SunYifan-IrV/Aircraft_Structure_design/README.md

# 飞行器结构设计 —— "人机合一"低空个人飞行器

> 第十二小组 · 飞行器结构设计大作业
> 一型低空个人飞行器（固定翼滑翔型）的**结构设计**全流程交付：需求 → 理论 → CATIA 建模 → 仿真校核 → 报告 / 汇报。

## 一句话定位

一根 13 m 碳纤维刚性梯形机翼 + 中央承力盒/龙骨 + 乘员俯卧挂载 + 后置折叠电推进 + 重心移动操纵 + 双腿起降的**无尾飞翼式单人动力滑翔机**。乘员不是乘客，而是结构—传力—操纵链中的一环（"人机合一"）。

## 目录结构

| 目录 | 内容 | 关键交付物 |
|---|---|---|
| [`00_Requirments`](00_Requirments/) | 设计需求冻结 | 设计需求、质量预算、载荷工况 |
| [`01_Theory`](01_Theory/) | 理论设计 | 总体参数、翼型/速度、升力分布/翼根内力、翼面结构、中央承力框架 |
| [`02_CATIA`](02_CATIA/) | 三维建模 | 设计思路、逐部件尺寸规格、CATPart |
| [`03_FEA`](03_FEA/) | 仿真分析 | 网格/应力/气动报告、数值结果、图件 |
| [`04_Report`](04_Report/) | 分析报告 | 汇总报告（docx） |
| [`05_Presentation`](05_Presentation/) | 答辩汇报 | 汇报 PPT |
| [`06_AI_Statment`](06_AI_Statment/) | AI 使用说明 | AI 使用声明 |

## 设计一页摘要

| 项 | 值 |
|---|---|
| 起飞质量 | 名义 135 kg / MTOW 155 kg（空机 60 kg） |
| 机翼 | S = 20 m²，b = 13 m，AR = 8.45，λ = 0.5，MAC = 1.60 m |
| 翼型 | 主翼 Wortmann FX 63-137，翼尖 E387 过渡 + −2° 洗流 |
| 速度 | V_stall 8.5–9.1 m/s，V_C = 15 m/s，V_NE = 25 m/s，V_D = 27.8 m/s |
| 翼根内力（极限 +6g） | V = 4.6 kN，M = 12.9 kN·m |
| 主梁 | CFRP 盒型梁，d = 200 mm，缘条 20×8 mm（根），夹芯腹板 |
| 翼肋 / 蒙皮 | 泡沫夹芯翼肋 @0.45 m（14 肋/侧）；±45° CFRP + Nomex D-box |
| 翼根连接 | 中央承力盒 + 7075-T6 铰耳/销（折叠） |
| 人体支撑 | 躯干成型托板，接触压力 ≤ 15 kPa @+4g |
| 支配约束 | 阵风（缓和后 n≈3g < +6g 机动）、颤振（D-box 抗扭） |

## 关键结论

1. 低失速（8–9 m/s 双脚软着陆）强制出**大翼面积 20 m²、低翼载 ~66–76 N/m²、高展弦比 8.45**；
2. 主梁按 **+4g/+6g 机动极限**设计（翼根 M = 12.9 kN·m），阵风经缓和因子后（n≈3g）不超机动极限，但运行包线须限制强阵风高速飞行；
3. **人体必须用大面积躯干托板（非窄带）**传递载荷，+4g 接触压力 14.9 kPa 才能满足生物力学限值；
4. **中央承力盒**是气动载荷、人体反力、螺旋桨推力、起降冲击四类载荷的汇合枢纽。

## 快速导航

- 设计需求：`00_Requirments/00_设计需求.md`
- 理论总览：`01_Theory/00_理论设计总览.md`
- 建模思路：`02_CATIA/00_设计思路.md`；逐部件尺寸：`02_CATIA/02_详细设计描述.md`
- 仿真交付：`03_FEA/README_交付说明.md`
- 汇总报告：`04_Report/分析报告.docx`
- 答辩汇报：`05_Presentation/飞行器结构设计报告.pptx`
- AI 使用声明：`06_AI_Statment/AI使用声明.md`

## 工具与可复现性

- **理论计算**：AI 辅助编写的 Python 脚本 `calc_wing.py` —— 全部数值可复现，改动参数后重跑即更新；
- **仿真**：Python 3.12 + numpy + python-docx + Pillow + gmsh 4.15.2，网格划分、升力线气动与梁模型强度计算均由脚本完成；
- **建模**：CATIA V5R21（`02_CATIA/PersonalAircraft_Structural_RevP.CATPart`）；
- **文档 / 汇报**：Word / PowerPoint（报告、汇报 PPT）。
