SunYifan-IrV/Aircraft_Structure_design/01_Theory/00_理论设计总览.md

# 00 理论设计总览（01_Theory）

本目录完成“人机合一”低空个人飞行器（固定翼滑翔型）的**理论设计**：总体参数、气动（翼型/速度/升力分布/翼根内力）与结构初步选型。

## 文档索引

| 文件 | 内容 | 对应任务 |
|---|---|---|
| [01_总体质量与翼面参数.md](01_总体质量与翼面参数.md) | 总质量、翼面积、翼展/弦长/展弦比 | 任务 1、2 |
| [02_翼型选择与设计速度.md](02_翼型选择与设计速度.md) | 候选翼型、设计飞行速度 | 任务 3 |
| [03_升力分布与翼根内力.md](03_升力分布与翼根内力.md) | Schrenk 升力分布、翼根剪力/弯矩、阵风 | 任务 4 |
| [04_翼面结构初步设计.md](04_翼面结构初步设计.md) | 翼梁/翼肋/蒙皮/翼根连接 | 任务 5 |
| [05_中央承力框架与人体传力路径.md](05_中央承力框架与人体传力路径.md) | 中央承力框架、人体支撑载荷链 | 任务 6 |
| `calc_wing.py`（本地保留） | 全部数值的可复现计算脚本，AI 辅助编写，未随仓库公开 | 校核/溯源 |

## 设计点一页摘要

| 项 | 值 |
|---|---|
| 起飞质量 | 名义 135 kg / MTOW 155 kg（空机 60 kg） |
| 机翼 | S = 20 m²，b = 13 m，AR = 8.45，λ = 0.5，MAC = 1.60 m |
| 翼型 | 主翼 Wortmann FX 63-137，翼尖 E387 过渡 + −2° 洗流 |
| 速度 | V_stall 8.5–9.1 m/s，V_C = 15 m/s，V_NE = 25 m/s，V_D = 27.8 m/s |
| 翼根内力（极限 +6g） | V = 4.6 kN，M = 12.9 kN·m |
| 主梁 | CFRP 盒型梁，d=200 mm，缘条 20×8 mm（根），夹芯腹板 |
| 翼肋/蒙皮 | 泡沫夹芯翼肋 @0.45 m（14 肋/侧）；±45° CFRP + Nomex D-box |
| 翼根连接 | 中央承力盒 + 7075-T6 铰耳/销（折叠） |
| 人体支撑 | 躯干成型托板，接触压力 ≤ 15 kPa @+4g |
| 支配约束 | 阵风（缓和后 n≈3g < +6g 机动）、颤振（D-box 抗扭） |

## 关键结论

1. 低失速（8–9 m/s 软着陆）强制出**大翼面积 20 m²、低翼载 ~66–76 N/m²**、高展弦比 8.45；
2. 主梁按 **+4g/+6g 机动极限**设计（翼根 M=12.9 kN·m），阵风经缓和因子后（n≈3g）不超机动极限，但运行包线须限制强阵风高速飞行；
3. **人体必须用大面积躯干托板**（非窄带）传递载荷，+4g 接触压力 14.9 kPa 才能满足生物力学限值；
4. 中央承力盒是气动载荷、人体反力、螺旋桨推力、起降冲击四类载荷的汇合枢纽。

## 后续衔接

- `02_CATIA`：翼型曲线、平面形状、中央承力盒/龙骨/托板的几何建模；
- `03_FEA`：主梁/翼根接头/承力盒强度与屈曲、颤振/气弹校核、接触压力细化；
- 本目录所有数值由计算脚本 `calc_wing.py` 生成（AI 辅助编写，小组本地保留，未随仓库公开），改动参数后重新运行即可更新。
