SunYifan-IrV/Aircraft_Structure_design/02_CATIA/02_详细设计描述.md

# 02 详细设计描述 —— 逐部件几何与结构规格

> 本文件是 **CATIA 建模的完整尺寸规格**。
> 设计思路见 [`00_设计思路.md`](00_设计思路.md)；数值源头为 `01_Theory` 的计算脚本 `calc_wing.py`（小组本地保留，未随仓库公开）。

## 0. 坐标系与基准

- **机体坐标系**：原点 = 根弦前缘 @ 机身中线 @ 弦线高度；
  - `x` 向后（顺气流，+x = 尾向），`y` 向右翼（+y = 右/星侧），`z` 向上；
- **基准平面**：弦线平面 z=0（机翼参考弦线所在平面），纵平面 y=0，翼根平面 x 为机翼展向坐标。
- 图纸比例 1:12.5；单位统一为 **m / kg / N**。

---

## 1. 总体参数（设计点冻结）

| 参数 | 符号 | 数值 |
|---|---|---|
| 名义 / 最大起飞质量 | m | 135 / 155 kg |
| 空机质量 | m₀ | 60 kg |
| 机翼面积 | S | 20 m² |
| 翼展 | b | 13 m（半翼展 6.5 m，折叠后 ~5.7 m/段） |
| 展弦比 | AR | 8.45 |
| 锥度比 | λ | 0.5 |
| 根弦 / 梢弦 | c_r / c_t | 2.05 / 1.03 m |
| 平均几何弦长 / 平均气动弦长 | c̄ / MAC | 1.54 / 1.60 m（MAC 位于 y=2.89 m） |
| 翼载（名义/最大） | W/S | 66.2 / 76.1 N/m² |
| 设计最大升力系数 | CLmax | 1.5 |
| 失速 / 巡航 / 极限速度 | V | 8.5–9.1 / 13.4–15.5 / 25 m/s |
| 翼根极限内力（+6g） | V_ult / M_ult | 4.56 kN / 12.88 kN·m（单侧） |
| 总长 / 总高（折叠态参照） | — | ≈ 2.2 m（桨至头）/ ≈ 1.5 m（翼面至脚） |

---

## 2. 机翼

### 2.1 平面形状（俯视轮廓，由 S、b、λ 唯一确定）

直线梯形翼，**1/4 弦线不后掠**（Λ₁/₄ = 0）。半翼展 `s = |y| ∈ [0, 6.5]`：

```
局部弦长   c(s) = c_r − (c_r − c_t)·(s/6.5) = 2.05 − 1.02·(s/6.5)
前缘 x     x_LE(s) = 0.255·(s/6.5)          （梢前缘后移 = 0.25(c_r−c_t)）
后缘 x     x_TE(s) = x_LE(s) + c(s)
```

- 前缘后掠角 Λ_LE ≈ 2.3°，后缘前掠 Λ_TE ≈ 6.7°；
- 翼尖前缘位于 x=0.255 m、后缘 x=1.28 m。

### 2.2 翼型（截面）

| 展向段 | 翼型 | t/c | 说明 |
|---|---|---|---|
| 根 → 中段 | **Wortmann FX 63-137** | 13.7%（根处最大厚度 0.28 m） | 高 CLmax、大结构深度（容纳 200 mm 主梁） |
| 翼尖段 | **Eppler E387** 过渡 | ~9% | 减薄减阻、延迟翼尖失速 |

- 弯度 ~6%（高升力）；**−2° 洗流**（washout）自中段向翼尖线性扭转，使翼尖先于根部失速延迟；
- 精确翼型坐标在 CATIA 中导入（FX 63-137 / E387 标准坐标表），本图仅简化示意。

### 2.3 主梁（盒型梁，主承弯）

- 位置：**30% 弦长**处，贯穿全翼展，根部缘条形心距 `d_root = 200 mm`；
- 缘条：上下各一条**单向 CFRP（0°铺层）**，定宽 20 mm，厚度沿展向台阶递减（含 −3g 负过载，上下面等强）：

| η=2y/b | y (m) | 梁高 d (mm) | 极限弯矩 (N·m) | 缘条厚 (mm) |
|---|---|---|---|---|
| 0.00 根 | 0.00 | 200 | 12881 | **8.0** |
| 0.10 | 0.65 | 190 | 10107 | 6.7 |
| 0.25 | 1.63 | 175 | 6647 | 4.8 |
| 0.50 | 3.25 | 150 | 2630 | 2.2 |
| 0.75 | 4.88 | 125 | 551 | 0.6 |

- 腹板：双侧各 1 层 ±45° CFRP 织物（0.25 mm）+ 3 mm PMI 泡沫夹芯，总厚 ~3.5 mm（防剪切屈曲）。

### 2.4 翼肋（14 肋/侧）

- 间距 `s = 0.45 m`（半翼展 6.5 m → 14 肋/侧，含根肋/梢肋）；
- 载荷：根部单肋 ~274 N（限制）/ 412 N（极限），载荷很小；
- 构造：轻质泡沫芯 + CFRP 薄蒙皮，开减轻孔，与主梁腹板铆/胶接、外缘与蒙皮胶接；兼作襟副翼铰点与后缘支撑。

### 2.5 蒙皮与 D-box（抗扭 / 抗颤振）

- **前缘 D-box**：±45° CFRP 预浸料 + 5 mm Nomex 蜂窝夹芯，总厚 ~2 mm，构成主抗扭闭室（主梁前腹板为闭室后壁）；
- **后缘蒙皮**：轻质夹芯板，承受局部气动压力、维持外形；
- D-box 扭转刚度是抵御大展弦比柔性翼**颤振/气动弹性发散**的关键。

### 2.6 襟副翼（Flaperon）

- 位置：后缘、外段 `y = 2.6 → 6.5 m`（每侧）；
- 弦向：**0.25 × 局部弦长**；同时作副翼（差动滚转）与襟翼（增升/减速），配重心移动操纵。

### 2.7 上反角与折叠接头

- **上反角 Γ = 3°**（每侧），翼尖相对翼根抬高 6.5·tan3° ≈ 0.34 m；
- **折叠铰点**：`y = ±0.8 m`（η≈0.12），主梁上下缘条各一**柱销（pin）**传正应力、腹板剪力由螺栓组/剪切键传递；
- 接头：7075-T6 铝合金机加铰耳 + 高强钢铰销；折叠后单段长 ≈ 5.7 m。

---

## 3. 中央承力结构（翼根汇合枢纽）

| 部件 | 形式 | 尺寸 | 材料 |
|---|---|---|---|
| **中央承力盒** | CFRP 盒型梁，展向贯通翼根 | 展向 1.6 m（±0.8 m），深 200 mm，位于 30% 弦 | CFRP 单向 + 夹芯腹板 |
| **龙骨（keel）** | 纵向梁 | 长 1.8 m（x = −0.2 → 1.6），截面管/盒 | 铝 7075-T6 管 或 CFRP 盒 |
| **挂点/吊带系统** | 沿龙骨可调挂耳 + 芳纶织带 | 前挂点 x≈0.3、后挂点 x≈0.95，可前后调 | 7075-T6 + Kevlar 织带 |
| **螺旋桨塔（pylon）** | 后置斜撑管架 | 自龙骨后段（x≈1.5）向后上抬至 x≈1.95、z≈0.12 | 铝合金管架 |

- **中央承力盒**承担两侧翼根弯矩 12.9 kN·m（贯通）与剪力 4.6 kN（两侧反力），是四类载荷（气动/人体/推力/冲击）的汇合枢纽；
- **龙骨**承担挂点集中力（≤5.6 kN 极限）与螺旋桨推力（5 kW @15 m/s ≈ 330 N，爬升数百牛）；
- **挂点前后可调**实现配平，兼作重心移动操纵的低摩擦滑动/摆动自由度。

---

## 4. 人体与躯干托板（"人机合一"核心）

### 4.1 俯卧姿态

- 乘员俯卧于翼下，身体纵轴平行气流：头朝前（x≈−0.2 → +0.1），脚朝后（x≈1.55）；
- 躯干中心线 **z ≈ −1.05 m**（弦线下方），躯干厚度 ~0.25 m；
- 设计乘员 75 kg（范围 55–95 kg，结构按 95 kg）。

### 4.2 躯干托板（非窄带！）

- **胸板 + 骨盆板 + 大腿支撑**的一体成型托板，贴合俯卧体型，接触面积 ~0.25 m²；
- 材料：硬质托板（CFRP/铝）+ 高密度泡棉 + 芳纶织带；
- 接触压力校核（关键）：

| 支撑形式 | 接触面积 | 95 kg @+1g | 95 kg @+4g |
|---|---|---|---|
| 仅胸带+骨盆带 | 0.055 m² | 16.9 kPa | 67.8 kPa ❌ |
| **躯干托板** | 0.25 m² | 3.7 kPa | **14.9 kPa ✅** |

- 生物力学限值：舒适 <10 kPa、短时 <20–30 kPa → 托板方案达标。

### 4.3 挂带

- 芳纶织带（抗拉 ~2900 MPa）从龙骨前/后挂点下引至托板，把升力大面积传入人体；数根并联，极限 ≥5.6 kN 安全裕度大。

---

## 5. 动力与能量

| 部件 | 规格 | 位置 |
|---|---|---|
| 电机 | 无刷直流，峰值 5 kW，巡航 ~2 kW | pylon 顶部（x≈2.0，z≈0.12） |
| 螺旋桨 | **后置折叠桨 Ø1.2 m**，2 叶，滑翔折叠减阻 | 桨盘竖直（y–z 面），位于 x≈2.05 |
| 电池 | 锂离子 3.0 kWh / 48 V ≈ 14 kg | 龙骨上，x≈0.4 → 1.2（前后可调配平） |
| 推力路径 | 螺旋桨 → pylon → 龙骨 → 中央承力盒 → 机翼 | — |

- 推进为**辅助**（起飞/爬升/应急返航）；核心飞行模式为滑翔/热气流翱翔。

---

## 6. 起落装置（双腿）

- 人体双腿即起落架：助跑起飞（逆风/坡度下 ~15–25 m，电推进辅助）、flare 拉平后**双脚软着陆**；
- 飞行时双腿收拢/微屈呈流线型；着陆瞬间经 双腿→骨盆→托板→挂带→龙骨 逆向传力（触地 ~2–3g）。

---

## 7. 材料清单

| 部件 | 材料 | 说明 |
|---|---|---|
| 机翼主梁缘条 | 单向 CFRP（0°） | 压缩许用 400 MPa / 拉伸 900 MPa（含折减） |
| 蒙皮/D-box/腹板 | ±45° CFRP + Nomex/PMI 夹芯 | 剪切 60 MPa |
| 翼肋 | 泡沫芯 + CFRP 薄蒙皮 | — |
| 中央承力盒 | CFRP 盒型梁 | 与翼根主梁同级别 |
| 龙骨 | 铝 7075-T6 | — |
| 挂点/铰耳/接头 | 铝 7075-T6 机加 | 与 CFRP 胶—螺栓混合连接 |
| 铰销/关键件 | 高强钢（30CrMnSiA / 4130） | — |
| 挂带 | 芳纶 Kevlar 织带 | 抗拉 ~2900 MPa |

---

## 8. 主要载荷工况（结构校核依据，供 03_FEA）

| 工况 | 过载/载荷 | 关键构件 |
|---|---|---|
| 极限机动 | +6g / −3g（限制 ×1.5） | 主梁、蒙皮（翼根 M=12.9 kN·m） |
| 垂直阵风 | 9 m/s @V_D，缓和后 n≈3g（限制） | 主梁、蒙皮（支配工况，运行限速） |
| 起降冲击 | flare 触地 2–3g 经双腿 | 挂点、挂带、人体 |
| 颤振/发散 | V_D ≥ 1.2·V_NE | 全翼（D-box 抗扭） |
| 疲劳 | 反复起降/阵风 | 挂点、主梁接头 |

---

## 9. 装配关系与建模提示

1. 所有机翼截面绕**1/4 弦线**（不后掠）布置，主梁在 30% 弦，D-box 前缘闭室与主梁前腹板闭合；
2. 中央承力盒是**展向贯通件**，与两侧外段翼在 y=±0.8 m 铰点对接；
3. 龙骨纵向连接中央承力盒下缘，挂点、电池、pylon 均装于龙骨；
4. 人体模型（俯卧）挂在托板上，托板经挂带连到挂点——**重心位置由挂点前后位置最终确定**，建模后需做重心校核。
