SunYifan-IrV/Aircraft_Structure_design/05_Presentation/飞行器结构设计报告.pptx

飞行器结构设计 · 第十二组大作业汇报

飞行器结构设计分析报告

「人机合一」低空个人飞行器 —— 无尾飞翼式单人动力滑翔机

结构设计 · 仿真分析 · 总结思考

2026 · 第十二小组

Notes: 开场：各位老师好，我们第十二小组汇报「飞行器结构设计」大作业——一型「人机合一」低空个人飞行器，一台无尾飞翼式单人动力滑翔机。下面从结构设计、仿真分析、总结思考三部分汇报。

## Slide 2

CONTENTS

分工

结构设计

· 总体参数 · 翼面结构
发动机布局，中央承力框架设计 ·

仿真分析

网格划分 · 应力分析
气动仿真（极曲线 · 压力云图）

01

02

Notes: 目录：第一部分结构设计（需求、总体参数、翼型、翼面结构、中央承力框架），第二部分仿真分析（网格、应力、气动），第三部分总结与边界。

## Slide 3

01

设计定位与需求

「人机合一」三原则

定位

一根 13 m 碳纤维刚性梯形机翼 + 中央承力盒/龙骨 + 乘员俯卧挂载 + 后置折叠电推进 + 重心移动操纵 + 双腿起降 —— 无尾飞翼式单人动力滑翔机。

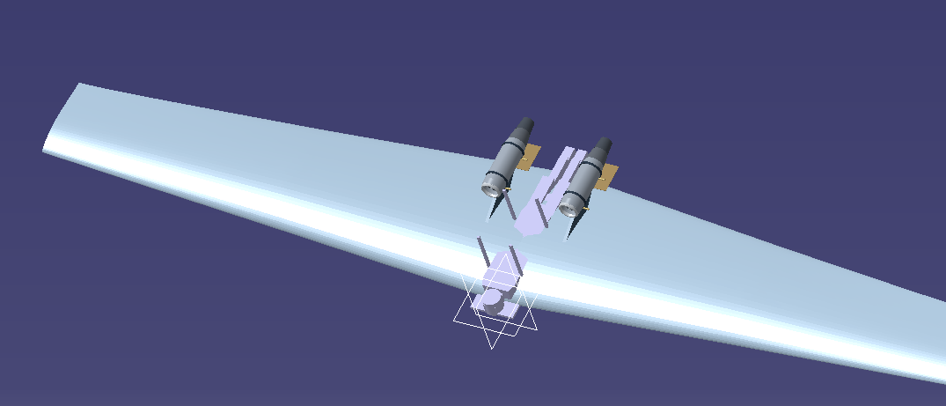
[picture p16: figure]

第一性原理硬约束

- 人体不是乘客，而是结构—传力—操纵链中的一环；
- 结构既承受气动载荷，又沿明确路径把载荷传到人体；
- 人体质量参与重心控制（weight-shift），双腿即起落装置。

低失速 → 低翼载

高升阻比 → 高展弦比

诱导阻力 ∝ 1/AR，取 AR≈8.45

双脚软着陆需 V_stall ≈ 8–9 m/s

能量密度 → 续航

人体功率 ~300 W

3 kWh 锂电 ≈ 14 kg，平飞 25–30 min

≪ 平飞 ~1.2 kW，必须外部能源

1

2

3

4

助跑起飞

→

爬升 / 盘旋

→

巡航 / 翱翔

→

滑翔 flare

→

双脚软着陆

任务剖面

3

Notes: 设计定位：低空个人运动/娱乐飞行 + 热气流翱翔。三原则：人体不是乘客而是结构—传力—操纵链的一环；结构沿明确路径把气动载荷传到人体；人体质量参与重心控制、双腿即起落架。第一性原理硬约束：低失速→低翼载、高升阻比→高展弦比、能量密度决定续航；人体功率约300瓦远小于平飞约1.2千瓦，所以必须有外部能量源。任务剖面：助跑起飞、爬升/盘旋、巡航/翱翔、滑翔flare双脚软着陆。

## Slide 4

01

总体参数与翼面

20 m²

机翼面积 S

13 m

翼展 b

8.45

展弦比 AR

155 kg

最大起飞质量 · 名义 135 kg

质量预算

项目 | 质量
空机质量 | 60 kg
名义乘员（范围 55–95） | 75 kg
名义起飞质量 | 135 kg
最大乘员 / MTOW | 95 / 155 kg

翼面与速度包线

参数 | 数值
锥度比 λ / 根弦·梢弦 | 0.5 / 2.05·1.03 m
平均气动弦长 MAC | 1.60 m
翼载 名义/最大 | 66.2 / 76.1 N/m²
失速 / 巡航 / 极限 | 31–33 / 48–56 / 90 km/h
材料体系 | CFRP · 7075-T6 · 芳纶

空机 60 kg = 主结构30 + 挂架7 + 电推进6 + 电池14 + 操纵2 + 杂项1

失速反推 S≈20.4 → 取 20 m²；低失速（8–9 m/s 双脚软着陆）→ 低翼载 66–76 N/m² → 高展弦比 8.45

4

Notes: 总体参数：空机60公斤、名义乘员75公斤，名义起飞135、最大155公斤。机翼面积20平方米由失速约束反推（双脚软着陆需要失速8–9米/秒），翼展13米、展弦比8.45、锥度比0.5、MAC 1.60米，翼载66–76牛/平方米。速度包线：失速31–33、巡航48–56、极限90公里/小时。材料以碳纤维主梁蒙皮为主，7075-T6挂架、芳纶挂带。

## Slide 5

01

翼型选择与翼根内力

翼型方案

- 主翼 Wortmann FX 63-137（t/c 13.7%，根处厚 0.28 m 容纳 200 mm 主梁）
- 翼尖 E387 过渡 + −2° 洗流（延迟翼尖失速，等效 CLmax≈1.5）
- Re ≈ 1–2.7×10⁶ 低雷诺数段，高 CLmax、大结构深度、L/D 好
- 升力线斜率 CLα = 4.92 rad⁻¹（0.0858 /°）

升力分布与阵风校核

- Schrenk 升力分布（椭圆 + 平面弦长平均），合力位于 43.4% 半翼展
- 阵风支配：9 m/s @ V_D 未缓和 Δn≈+9.9g → 缓和因子 K_g=0.205 后 n≈3g < +6g
- → 主梁仍按机动极限设计，运行包线须限速

工况（单侧） | V_root | M_root
限制 +4g | 3.04 kN | 8.59 kN·m
极限 +6g | 4.56 kN | 12.88 kN·m
极限 −3g | −2.28 kN | −6.44 kN·m

12.88 kN·m

翼根极限弯矩（+6g @ MTOW）—— 主梁主导工况

纯椭圆分布 8.39 kN·m，Schrenk 因梯形升力外移 +2.4%（偏保守）

5

Notes: 翼型：主翼选Wortmann FX 63-137，13.7%厚度在根弦2.05米下给出0.28米最大厚度，正好容纳200毫米主梁；翼尖向E387过渡并施加−2°洗流以延迟翼尖失速。升力分布用Schrenk近似。翼根极限内力：+6g时单侧剪力4.56千牛、弯矩12.88千牛·米。阵风是支配工况：9米/秒阵风在V_D下未缓和约10g，缓和因子0.205后降到3g，所以主梁仍按机动极限设计、运行包线限速。

## Slide 6

01

翼面结构（主梁 / 翼肋 / 蒙皮 / 翼根）

腹板

双侧 ±45° CFRP 织物 + 3 mm PMI 夹芯（总厚 ~3.5 mm），防止深 200 mm 薄腹板剪切屈曲

主梁

CFRP 盒型梁 @30% 弦，根部缘条形心距 d=200 mm；缘条单向 CFRP 定宽 20 mm，厚度台阶递减 8→6→4→2 mm（上下等强，兼顾 −3g）

1

2

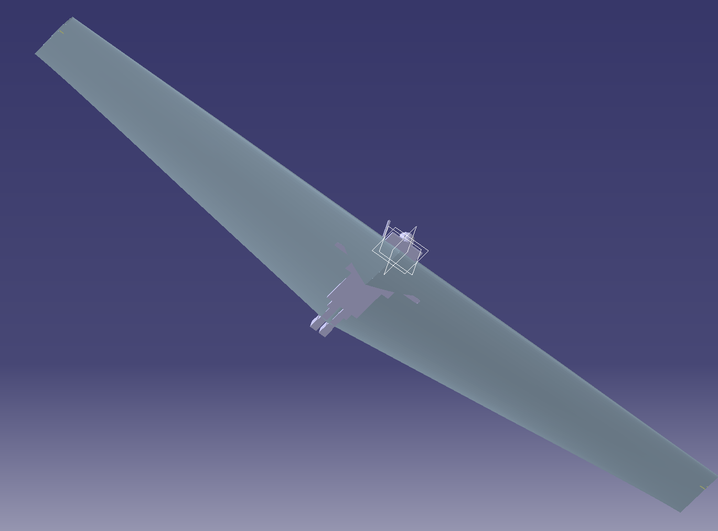
[picture p17: figure]

翼肋

泡沫夹芯 @0.45 m，14 肋/侧；根肋载荷仅 ~274 N（限制）/ 412 N（极限）

3

4

主梁缘条沿展向递减

展向位置 y (m) | 0.00 | 0.65 | 1.63 | 3.25 | 4.88
梁高 d (mm) | 200 | 190 | 175 | 150 | 125
极限弯矩 (N·m) | 12881 | 10107 | 6647 | 2630 | 551
缘条厚 t (mm) | 8.0 | 6.7 | 4.8 | 2.2 | 0.6

6

Notes: 翼面结构：主梁为碳纤维盒型梁，位于30%弦，根部缘条形心距200毫米；缘条单向碳纤维定宽20毫米、厚度沿展向8→6→4→2毫米台阶递减。腹板用±45°织物加3毫米PMI泡沫夹芯防剪切屈曲。翼肋泡沫夹芯间距0.45米、每侧14肋。前缘D-box用±45°碳纤维加5毫米Nomex夹芯，是主抗扭闭室、抗颤振关键。翼根用中央承力盒加7075-T6铰耳销折叠，铰点y=±0.8米，折叠后单段5.7米。

## Slide 7

01

中央承力框架与人体传力路径

传力路径（闭合传力环）

气动升力

→

主梁

→

中央承力盒

→

挂点 / 吊带

→

躯干托板·人体

人体重力（惯性反力）反作用于机翼 → 闭合传力环；推力 / 起降冲击走同一套结构的逆路径

中央承力四大部件

部件 | 形式 / 功能
中央承力盒 | CFRP 盒型梁 1.6 m，汇合两侧翼根弯矩 12.9 kN·m
龙骨 | 铝 7075-T6 纵向梁 1.8 m，挂点/电池/pylon 载体
挂点 / 吊带 | 可调挂耳 + 芳纶织带，兼作重心移动操纵机构
螺旋桨塔 | 后置管架，5 kW 电机 + 折叠桨，推力传入龙骨

人体支撑接触压力校核（关键）

窄带方案

67.8

kPa @ +4g

✕ 不可接受

躯干托板

14.9

kPa @ +4g

✓ 满足限值

结论：必须用大面积躯干托板（胸板 + 骨盆板 + 大腿），把集中力扩散为 <15 kPa 的大面积接触压力（限值 20–30 kPa 短时）。

7

Notes: 中央承力框架：中央承力盒贯穿翼根1.6米，是两侧翼根弯矩的汇合枢纽；龙骨纵向1.8米承载挂点、电池、螺旋桨塔。传力路径：气动升力→主梁→承力盒→挂点→芳纶吊带→躯干托板→人体→重力闭合。关键是接触压力：窄带方案+4g达67.8千帕不可接受，大面积躯干托板把压力降到14.9千帕，满足生物力学限值——这是把人体安全纳入结构链的先决条件。

## Slide 8

02

仿真分析 · 网格划分

RevN · 结构翼盒网格


RevP · 完整外形网格


36.4 万

RevN 三角面数

130 万

RevP 三角面数

18 / 3.6 mm

全局 / 最小尺寸

Delaunay

网格算法（Frontal-Delaunay）

两版共用同一套升力线载荷源：RevN（结构翼盒）用于应力，RevP（补齐前缘 D-box 与后缘蒙皮，0–100% 弦长）用于气动。

8

Notes: 网格划分：几何分RevN（结构翼盒）和RevP（完整外形）两版，都采用18毫米全局、3.6毫米最小尺寸、Frontal-Delaunay算法。RevN约36万三角面用于结构，RevP约130万三角面补齐前缘与后缘蒙皮用于气动。

## Slide 9

02

仿真分析 · 应力分析

主梁 von Mises 应力云图（+6g）


y (m) | M (N·m) | σ (MPa) | MS | 挠度 (m)
0.09（根） | 11327 | 364 | 0.099 | 0.408
1.63 | 5668 | 333 | 0.20 | 0.20
3.25 | 1915 | 290 | 0.38 | 0.06
4.88 | 292 | 195 | 1.05 | 0.01

364 MPa

缘条最大应力（许用 400）

0.10

安全裕度 MS

0.41 m

翼尖挠度（6.3% 半展长）

6g 翼根弯矩 11.33 kN·m（设计 12.88，−12%）；腹板剪应力 ≈3.3 MPa（许用 60）；结构满足强度与刚度要求。

9

Notes: 应力分析：在+6g极限载荷下用盒型梁模型计算。翼根弯矩11.33千牛·米，较设计值12.88低12%；缘条最大应力364兆帕、许用400兆帕，安全裕度0.10；腹板剪应力仅3.3兆帕；翼尖挠度0.41米，约为半展长的6.3%。结构满足强度与刚度要求。

## Slide 10

02

仿真分析 · 气动仿真（极曲线）

阻力极曲线 CL–CD

α (°) | CL | CDi | CD | L/D
−4 | 0.18 | 0.0012 | 0.0137 | 13.0
0 | 0.53 | 0.0106 | 0.0231 | 22.9
4 | 0.88 | 0.0294 | 0.0419 | 21.0
8 | 1.23 | 0.0576 | 0.0701 | 17.5


展向载荷分布


22.8

最大升阻比 L/D @ CL=0.60

0.66 m/s

巡航下沉率（135 kg, 15 m/s）

Prandtl 升力线 + 薄翼理论（势流）：升力线斜率 0.0876/°，巡航点 CL=0.48、α=0.15°、L/D≈22.7。展向载荷与 Schrenk 近似吻合。

10

Notes: 气动仿真：用Prandtl升力线方法得到极曲线。升力线斜率0.0876每度，最大升阻比22.8对应CL=0.60；巡航点（135公斤、15米/秒）CL=0.48、迎角0.15°、升阻比约22.7、下沉率0.66米/秒。展向载荷与Schrenk近似吻合。

## Slide 11

02

仿真分析 · 气动仿真（表面压力）

下表面压力系数 Cp

上表面压力系数 Cp


上表面负压区是主要升力来源；

结构网格导入 ANSYS 做三维壳单元 FEA。

11

Notes: 表面压力云图：把升力线解析场映射到网格着色，展示上下表面Cp分布，上表面负压区对应主要升力来源。注意这是势流解析场映射，不是RANS结果。

## Slide 12

恳请老师批评指正

谢谢聆听 · 第十二小组

分工：建模与统筹 孙一凡 · 结构分析 冯异 · 气动/有限元 张文博 · 总结报告 翁丁恺

AI 说明：使用 Claude（Claude Code / Opus 5.5）辅助设计分析与文档草拟，结论经人工复核，由本组负责。

Notes: 以上就是我们的汇报，恳请各位老师批评指正。分工：建模与统筹孙一凡、结构分析冯异、气动/有限元张文博、总结报告翁丁恺。本作业使用Claude辅助设计分析与文档草拟，结论经人工复核，由本组负责。谢谢！
