SunYifan-IrV/Aircraft_Structure_design/01_Theory/02_翼型选择与设计速度.md

# 02 翼型选择与设计飞行速度

> 对应任务：**选定候选翼型和设计飞行速度**
> 计算脚本：`calc_wing.py`（AI 辅助编写，小组本地保留，未随仓库公开）

## 1. 运行雷诺数

翼型性能由雷诺数决定。按平均气动弦长 `MAC = 1.595 m`、海平面 `ρ=1.225 kg/m³`、`μ=1.81×10⁻⁵ Pa·s`：

| 状态 | 速度 V | Re = ρVc/μ |
|---|---|---|
| 失速（最大质量） | 9.1 m/s | ≈ 0.98×10⁶ |
| 巡航 | 15 m/s | ≈ 1.62×10⁶ |
| V_NE | 25 m/s | ≈ 2.70×10⁶ |

**设计雷诺数区间 ≈ 1×10⁶ – 2.7×10⁶**。该区间属“低雷诺数”范畴：需选在 `Re ~ 1–3×10⁶` 具有高 `CLmax` 与良好 `L/D` 的翼型，且厚度足够提供结构深度。

## 2. 候选翼型对比

| 翼型 | 厚度 t/c | 弯度 | 特点 | 适用性 |
|---|---|---|---|---|
| **Wortmann FX 63-137** | ~13.7% | ~6% | 高升力、低雷诺数高效、较厚 | **首选**：CLmax 高、结构深度大、L/D 好 |
| Selig S1223 | ~12.1% | ~8.7% | CLmax 极高 (~2.2)，但低头力矩大 (Cm≈−0.3) | 备选：极限增升，代价是配平阻力大 |
| Eppler E387 | ~9.0% | ~4.5% | 低 Re 高 L/D，但薄、CLmax 偏低 | 备选：翼尖段减阻/减薄 |
| NACA 4415 | 15% | 4% | 厚、易制造、CLmax ~1.5，L/D 中等 | 备选：最易制造的结构稳健方案 |

### 2.1 选定方案

**主翼型：Wortmann FX 63-137**（根至中段）。

- 13.7% 厚度在根弦 2.05 m 下给出 ~280 mm 最大厚度，为翼梁提供足够缘条间距；
- 高弯度保证 `CLmax ≈ 1.6`（Re≈1×10⁶），配合襟副翼即可覆盖设计 `CLmax = 1.5`；
- 低雷诺数段升阻特性好，支撑 `(L/D)max ≈ 15` 的滑翔需求。

**翼尖段：向 Eppler E387（或 S7012）过渡**，并施加 **−2° 洗流（washout）**：

- 翼尖更薄 + 洗流使翼尖先于根部失速延迟，避免大展弦比翼的翼尖失速/滚转失控；
- 洗流使翼尖当地升力系数略降，全翼等效 `CLmax` 由 1.6 折减至设计值 **1.5**，与失速反推一致。

> 2D 极曲线（CL–α、CL–CD、Cm）与襟副翼偏度需在气动细化阶段用 XFOIL/XFLR5 复核；本阶段采用目录值。

## 3. 设计飞行速度包线

以 `S=20 m²`、`CLmax=1.5`、`W=1324 N`（名义）为基准，由 `V = √(2W/(ρ·S·CL))` 反推各状态：

| 状态 | CL | 速度 (m/s) | 速度 (km/h) |
|---|---|---|---|
| 失速（名义质量） | 1.5 | 8.5 | 31 |
| 失速（最大质量） | 1.5 | 9.1 | 33 |
| 最佳滑翔 (L/D)max | ~0.72 | 12.3 | 44 |
| **设计巡航 V_C** | 0.45–0.60 | **13.4–15.5** | 48–56 |
| 极限速度 V_NE | — | 25.0 | 90 |
| 设计俯冲速度 V_D = 1.11·V_NE | — | 27.8 | 100 |

### 3.1 设计飞行速度的选定

- **设计巡航速度 `V_C = 15 m/s (54 km/h)`**：位于升阻比峰值附近、失速速度的 ~1.7 倍，兼顾滑翔效率与操纵裕度；
- **最佳滑翔速度 `~12.3 m/s (44 km/h)`**：无动力翱翔/热气流盘旋的典型工作点，对应最小下沉率区间；
- **V_NE = 25 m/s**、**V_D = 27.8 m/s**：结构极限校核用（阵风、颤振见 03、04 章）。

> 需求文档 §3.2 中 “巡航 CL≈0.65 → 14–16 m/s” 与 `√(2W/(ρS·0.65))≈12.9 m/s` 存在细微偏差；此处以公式为准：巡航 CL≈0.45–0.60 对应 13.4–15.5 m/s，结论（巡航 50–58 km/h）不变。

## 4. 升力线斜率（供阵风/操纵计算）

薄翼理论 `a₀ = 2π`，有限翼展修正（Oswald 效率 `e=0.85`）：

```
CLα = a₀ / (1 + a₀/(π·e·AR))
    = 6.283 / (1 + 6.283/(π × 0.85 × 8.45))
    = 4.92 rad⁻¹  (≈ 0.0858 /deg)
```

该值用于 03 章的阵风增量校核。
