SunYifan-IrV/Aircraft_Structure_design/03_FEA/figures/view_top.png

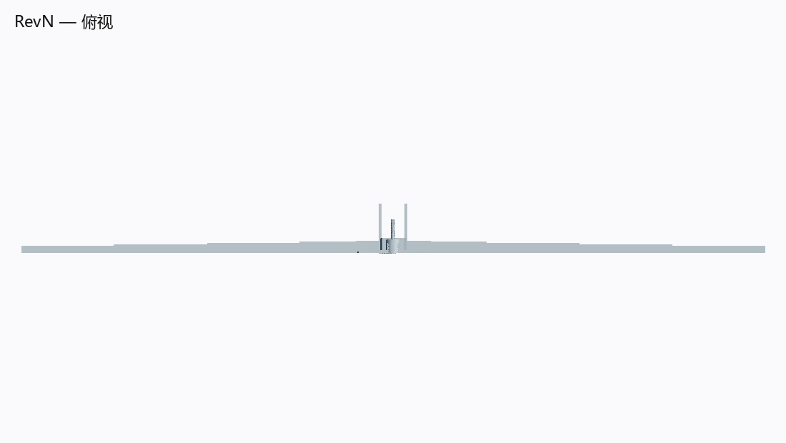
03_FEA/figures/view_top.png
