SunYifan-IrV/Aircraft_Structure_design/03_FEA/figures/wing_oml_front.png

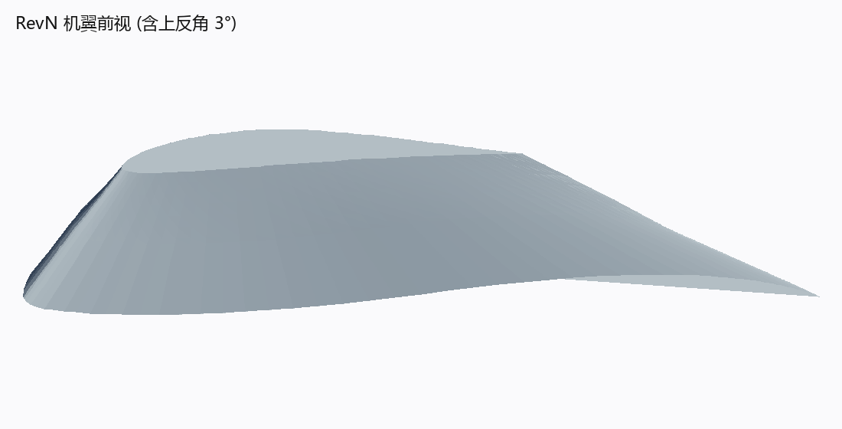
03_FEA/figures/wing_oml_front.png
