SunYifan-IrV/Aircraft_Structure_design/(list of files, cad)

Other CAD files:
02_CATIA/PersonalAircraft_Structural.CATPart
