SunYifan-IrV/Aircraft_Structure_design/03_FEA/results/ll_polar.csv

alpha | CL | CDi | CD0 | CD | LD
-6.0 | -0.05831186947591123 | 0.0010956458572745902 | 0.01249 | 0.013583453645372591 | -4.29286034305245
-5.5 | -0.014505537332660579 | 0.0009125237160209753 | 0.01249 | 0.013400331504118975 | -1.0824760065228152
-5.0 | 0.029300794810590017 | 0.0008766536444749688 | 0.01249 | 0.013364461432572968 | 2.1924411214338724
-4.5 | 0.07310712695384051 | 0.0009880356426365678 | 0.01249 | 0.013475843430734567 | 5.425050189222587
-4.0 | 0.11691345909709112 | 0.001246669710505775 | 0.01249 | 0.013734477498603775 | 8.51240675948367
-3.5 | 0.16071979124034175 | 0.0016525558480825892 | 0.01249 | 0.014140363636180589 | 11.366029571482313
-3.0 | 0.20452612338359225 | 0.0022056940553670094 | 0.01249 | 0.014693501843465009 | 13.919494859869365
-2.5 | 0.24833245552684277 | 0.002906084332359036 | 0.01249 | 0.015393892120457036 | 16.13188228055933
-2.0 | 0.29213878767009355 | 0.0037537266790586754 | 0.01249 | 0.016241534467156676 | 17.987142056118593
-1.5 | 0.3359451198133441 | 0.004748621095465916 | 0.01249 | 0.017236428883563915 | 19.490413129235264
-1.0 | 0.3797514519565946 | 0.0058907675815807635 | 0.01249 | 0.018378575369678764 | 20.662725174178295
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
