SunYifan-IrV/Aircraft_Structure_design/03_FEA/results/spanload_ll.csv

y_m | chord_m | cl_local | lift_per_span_N_m | alpha_i_deg | schrenk_N_m
-6.5 | 1.0294 | 0.0 | 0.0 | 0.121 | 34.1
-6.4994 | 1.0295 | 0.0076 | 1.07 | 0.124 | 34.95
-6.4978 | 1.0297 | 0.0151 | 2.15 | 0.134 | 35.81
-6.495 | 1.0302 | 0.0227 | 3.22 | 0.148 | 36.67
-6.4911 | 1.0308 | 0.0302 | 4.3 | 0.164 | 37.54
-6.4861 | 1.0316 | 0.0378 | 5.37 | 0.18 | 38.42
-6.48 | 1.0325 | 0.0453 | 6.44 | 0.192 | 39.3
-6.4727 | 1.0337 | 0.0527 | 7.51 | 0.198 | 40.18
-6.4644 | 1.035 | 0.0601 | 8.58 | 0.196 | 41.07
-6.4549 | 1.0365 | 0.0675 | 9.64 | 0.185 | 41.96
-6.4444 | 1.0381 | 0.0747 | 10.69 | 0.163 | 42.86
-6.4327 | 1.0399 | 0.0818 | 11.73 | 0.131 | 43.76
-6.42 | 1.042 | 0.0889 | 12.77 | 0.092 | 44.66
-6.4061 | 1.0441 | 0.0959 | 13.79 | 0.048 | 45.57
-6.3911 | 1.0465 | 0.1028 | 14.82 | 0.002 | 46.49
-6.3751 | 1.049 | 0.1096 | 15.85 | -0.044 | 47.4
-6.3579 | 1.0517 | 0.1164 | 16.87 | -0.086 | 48.32
-6.3397 | 1.0546 | 0.1232 | 17.91 | -0.122 | 49.25
-6.3204 | 1.0576 | 0.1301 | 18.96 | -0.149 | 50.18
-6.3 | 1.0608 | 0.137 | 20.02 | -0.168 | 51.11
-6.2785 | 1.0642 | 0.1439 | 21.1 | -0.178 | 52.04
-6.2559 | 1.0677 | 0.1509 | 22.2 | -0.18 | 52.97
-6.2323 | 1.0715 | 0.158 | 23.32 | -0.176 | 53.91
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
