SunYifan-IrV/Aircraft_Structure_design/03_FEA/results/strength.csv

y_m | M_Nm | cap_stress_MPa | MS | deflection_m | shear_N
0.085 | 11327.5 | 364.1 | 0.1 | -0.408 | -4477.2
0.17 | 10950.2 | 362.1 | 0.1 | -0.3946 | -4392.8
0.255 | 10580.2 | 360.2 | 0.11 | -0.3815 | -4308.6
0.34 | 10217.6 | 358.4 | 0.12 | -0.3686 | -4224.4
0.425 | 9862.3 | 356.5 | 0.12 | -0.3559 | -4140.5
0.51 | 9514.5 | 354.7 | 0.13 | -0.3435 | -4056.8
0.595 | 9174.1 | 352.9 | 0.13 | -0.3313 | -3973.5
0.679 | 8841.2 | 351.1 | 0.14 | -0.3194 | -3890.5
0.764 | 8515.7 | 349.1 | 0.15 | -0.3077 | -3807.9
0.848 | 8197.7 | 347.1 | 0.15 | -0.2962 | -3725.7
0.933 | 7887.1 | 345.2 | 0.16 | -0.2849 | -3643.9
1.017 | 7584.0 | 343.4 | 0.16 | -0.2739 | -3562.7
1.101 | 7288.3 | 341.6 | 0.17 | -0.2632 | -3482.0
1.185 | 7000.0 | 339.9 | 0.18 | -0.2527 | -3401.8
1.268 | 6719.1 | 338.2 | 0.18 | -0.2424 | -3322.3
1.351 | 6445.5 | 336.7 | 0.19 | -0.2324 | -3243.3
1.435 | 6179.3 | 335.2 | 0.19 | -0.2226 | -3164.9
1.517 | 5920.2 | 333.8 | 0.2 | -0.213 | -3087.1
1.6 | 5668.4 | 332.5 | 0.2 | -0.2037 | -3010.0
1.682 | 5423.8 | 330.1 | 0.21 | -0.1947 | -2933.6
1.764 | 5186.2 | 327.1 | 0.22 | -0.1859 | -2857.9
1.846 | 4955.7 | 324.1 | 0.23 | -0.1773 | -2782.8
1.928 | 4732.1 | 321.2 | 0.25 | -0.169 | -2708.6
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
