SunYifan-IrV/Aircraft_Structure_design/03_FEA/results/volumes.csv

tag | xmin | xmax | ymin | ymax | zmin | zmax | dy | dx | dz | area_mm2 | nfaces
2 | -200.0000001 | 1650.0000001 | -300.0000001 | 300.0000001 | -1e-07 | 35.0000001 | 600.0000002 | 1850.0000002000002 | 35.0000002 | 2391499.9999999995 | 6
8 | 19.9999999 | 930.0000001000076 | -225.0000001000185 | 225.0000001000185 | -1e-07 | 250.0000001 | 450.000000200037 | 910.0000002000075 | 250.0000002 | 1370815.160806838 | 10
1 | -200.0000001 | 1600.0000001 | -90.0000001 | 90.0000001 | -1e-07 | 160.0000001 | 180.0000002 | 1800.0000002000002 | 160.0000002 | 1281599.9999999998 | 6
18 | 399.9999999 | 1200.0000001 | -150.0000001 | 150.0000001 | -1e-07 | 220.0000001 | 300.0000002 | 800.0000002000002 | 220.0000002 | 964000.0 | 6
9 | 899.9999999 | 1370.0000001 | -205.000000100001 | 205.000000100001 | -1e-07 | 250.0000001 | 410.000000200002 | 470.00000020000004 | 250.0000002 | 760240.4115826463 | 8
63 | -1.0001904965074572e-07 | 2050.0000001 | -46.46272726492574 | 249.76227128689834 | -12.0000001 | 1e-07 | 296.22499855182406 | 2050.000000200019 | 12.000000199999999 | 746903.9046527739 | 82
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
