SunYifan-IrV/Aircraft_Structure_design/(commit log)

2026-10-29 complete the wing
    [Aircraft_Structure.CATPart, Aircraft_Structure.stp, Part6.CATPart, e387_loop.csv, fx63137_loop.csv]
2026-10-30 move the dictionary
    [Aircraft_Structure_20261030_113158.CATPart, Aircraft_Structure_20261030_113158.stp, Aircraft_Structure_test.stp, stage01.CATPart, stage02.CATPart, stage03.CATPart, stage04.CATPart, stage05.CATPart]
2026-10-30 fuck!CATIA make me awake until 3 a.m.
    [Aircraft_Structure.CATPart, Aircraft_Structure.stp, Aircraft_Structure_20261030_113158.CATPart, Aircraft_Structure_20261030_113158.stp, Aircraft_Structure_test.stp, Part6.CATPart, PersonalAircraft_Assembly.CATPart, PersonalAircraft_Structural_RevG.CATPart]
2026-11-01 all is well
    [PersonalAircraft_Assembly.CATPart, PersonalAircraft_Structural_RevG.CATPart, PersonalAircraft_Structural_RevM.CATPart, PersonalAircraft_Structural_RevN.CATPart, PersonalAircraft_Structural_RevO.CATPart, _wing_skin_leading_edges.csv, _wing_skin_sections.csv, aircraft_surface_bin.stl]
2026-11-02 chore: untrack AI-assisted scripts, mesh intermediates and delivery zip
    Remove from version control (files kept locally):
    - 01_Theory/scripts/, 03_FEA/scripts/, 05_Presentation/*.js|*.py|package.json
    - 03_FEA/mesh/ (STL + msh intermediates, ~173 MB)
    - 03_FEA/*.zip (delivery package, contents duplicated in repo)
    Update README, AI usage statement and 01_Theory / 02_CATIA / 03_FEA docs so
    references no longer point at untracked paths; AI-assist disclosure retained
    and states scripts are available on request.
    [aircraft_surface_bin.stl, revP_surface.stl, wing_oml.stl]
2026-11-02 docs: drop references to files that were never committed
    Remove dead links left over from earlier drafts:
    - 04_Report/00_报告补充章节.md (referenced by README and AI statement)
    - 05_Presentation/README.md per-page speaker notes (referenced by README)
    - 02_CATIA/01_三视图.svg (referenced by both CATIA docs)
    Also remove the '三视图怎么读' section in 00_设计思路.md, which existed
    solely to walk through that missing drawing. All dimensions it listed
    (翼展 13 m, 根弦 2.05 m, 梢弦 1.03 m, 上反 3°, 悬挂 1.05 m, 总长 ≈2.2 m,
    桨径 Ø1.2 m) are already documented in 02_详细设计描述.md, so no design
    data is lost. All 15 remaining relative links verified resolv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
2026-11-05 add engine
    [PersonalAircraft_Structural_RevP.CATPart, PersonalAircraft_Structural_RevQ_TwinTurbojet.CATPart]
2026-11-05 we finish all the task to make it better. The course is very nice and fruitful. The teacher, Mr. Liu is an absolutely great man~~
    [PersonalAircraft_Structural.CATPart, PersonalAircraft_Structural_RevQ_TwinTurbojet.CATPart, PersonalAircraft_Structural_RevQ_TwinTurbojet_Copy.CATPart, PersonalAircraft_Structural_RevQ_TwinTurbojet_SkinBeamAdjusted.CATPart, PersonalAircraft_Structural_RevQ_TwinTurbojet_Trial.CATPart]
